srobo-legacy/boards-jointio-hw/gerbers/README.txt

Student Robotics
Contact: Rob Spanton
Email:   rspanton@studentrobotics.org
Phone:   XXXXXXXXXXXX
--------------------------------------------------------------------------------
Board Reference:  sr_jointio
Board Issue:      SR13.F
--------------------------------------------------------------------------------
Bare Board Test:      Yes
Layers:               2
Copper Weight:        1oz
Material:             1.6mm FR4
Solder Resist:        GREEN on 2 sides
Silk Screen:          WHITE on 2 sides
--------------------------------------------------------------------------------
Layer Order:
top
bottom
--------------------------------------------------------------------------------
Gerber Files:
jointio.top.gbr       - Top Copper Layer
jointio.bottom.gbr        - Bottom Copper Layer
jointio.topmask.gbr   - Solder Mask Top
jointio.bottommask.gbr    - Solder Mask Bottom
jointio.toppaste.gbr  - Solder Paste Top
jointio.bottompaste.gbr   - Solder Paste Bottom
jointio.topsilk.gbr   - Silk Screen Top
jointio.bottomsilk.gbr    - Silk Screen Bottom
jointio.outline.gbr     - Board Outline
jointio.fab.gbr         - Fabrication/Drill Drawing
jointio.plated-drill.cnc   - Plated Hole Drill Information
jointio.unplated-drill.cnc - Unplated Hole Drill Information
--------------------------------------------------------------------------------
If there are any problems please contact Student Robotics using the details at
the top of this file.
