srobo-legacy/boards-jointio-hw/(list of files, drawings)

Other design files:
jointio.pcb
