srobo-legacy/boards-jointio-hw/(commit log)

2010-09-23 Add a makefile copied from the motor-hw.git repo
2010-09-23 Add .gitignore file copied from motor-hw.git
2010-09-23 Begin schematic
    [jointio.sch]
2010-09-23 Add SRIC symbol and MSP430F22x4 along with a decoupling cap
    [jointio.sch]
2010-09-23 Add the Spy-bi-wire programming header for the MSP
    [jointio.sch]
2010-09-23 Wire up SRIC to the MSP, same pin mapping as on the motor board
    [jointio.sch]
2010-09-23 Add input LEDs
    Controlled by the MSP, it detects the logic level present on the input
    and sets the corresponding LED accordingly.
    [jointio.sch]
2010-09-23 Allocate a port on the MSP for 8 outputs
    [jointio.sch]
2010-09-23 Move HT, GT and TX_EN signals onto pins that are not ADC inputs
    Unfortunately the pins that those signals were using are needed for the
    analogue inputs.
    [jointio.sch]
2010-09-23 Add nets for ADC inputs to MSP
    [jointio.sch]
2010-09-23 Add debugging/SRIC activity LED
    [jointio.sch]
2010-09-23 Shuffle stuff around in the schematic, no electrical changes
    [jointio.sch]
2010-09-23 Add input connector and protection resistors/clamping diodes
    [jointio.sch]
2010-09-23 Add TVS diodes to the 3.3V rail
    If all 8 inputs have 12V connected then 70mA will need to be drawn from
    the 3.3V rail to stop it from rising above 3.3V. The TVS diode should clamp
    the rail to a reasonable value under these conditions.
    [jointio.sch]
2010-09-23 Add output connector and driver FETs/polyfuses
    [jointio.sch]
2010-09-23 Actually name the nets connected to the input LEDs correctly
    [jointio.sch]
2010-09-23 Add output LEDs
    [jointio.sch]
2010-09-23 Schematic shuffle, not elec changes.
    [jointio.sch]
2010-09-24 Add the SMPS. Based on the design on the power board
    [jointio.sch]
2010-09-24 Add a power LED to the 3V3 SMPS rail
    [jointio.sch]
2010-09-24 Add a FET to enable/disable the SMPS from the MSP
    The pull-up disables the SMPS by default.
    [jointio.sch]
2010-09-24 Connect the SMPS to the output FETs
    [jointio.sch]
2010-09-24 Add values to the output FETs
    [jointio.sch]
2010-09-24 Add values to the input protection diodes
    [jointio.sch]
2010-09-24 Add value to SRIC 3.3V rail TVS diode
    [jointio.sch]
2010-09-24 Add 3.3V and GND connectors, both protected by polyfuses
    The GND connections need to be protected by a fuse just as much as the
    3.3V connections. If they can connect 12V to an input or output they
    can connect 12V to the GND connections.
    [jointio.sch]
2010-09-24 Add some TVS diodes to the SMPS 3.3V rail
    Don't want things breaking when they connect 12V to the 3.3V connector.
    It shouldn't matter too much if that rail does rise as it's only used
    for the 3.3V output connector and to power the output FETs.
    [jointio.sch]
2010-09-24 Add MSP value
    [jointio.sch]
2010-09-24 Add values to the remaining un-valued SMPS components
    [jointio.sch]
2010-09-24 Add values to the output polyfuses
    [jointio.sch]
2010-09-24 Add values to the 3.3V and GND connection polyfuses
    [jointio.sch]
2010-09-24 Add values to the input/output and 3.3V/GND connectors
    [jointio.sch]
2010-09-24 Add values to the input and output LEDs
    [jointio.sch]
2010-09-24 Change the LED and input protection resistors to resistor arrays
    They reduce the overall part count and therefore ease assembly
    [jointio.sch]
2010-09-24 Number all of the components
    [jointio.sch]
2010-09-24 Add footprint attributes to all components that use existing footprints
    [jointio.sch]
2010-09-25 Add footprint attributes to the resistor arrays and output FETs
    [jointio.sch]
2010-09-25 Add footprint attribute for SMPS inductor
    [jointio.sch]
2010-09-25 Add footprint attribs to the in/out/3.3/GND connectors and a misc resistor
    [jointio.sch]
2010-09-25 Generate initial PCB file. Setup units/grid/DRC/layers
    [jointio.pcb]
2010-09-25 Insert standard SRIC layout
    [jointio.pcb]
2010-09-25 Place the connectors around the edge of the board
    [jointio.pcb]
2010-09-26 Place input LEDs
    [jointio.pcb]
2010-09-26 Place output LEDs
    [jointio.pcb]
2010-09-26 Flip the LED resistor arrays around to ease routing
    [jointio.sch]
2010-09-26 Position input/output LED resistors
    [jointio.pcb]
2010-09-26 Swap input and output connectors around, eases routing
    [jointio.pcb]
2010-09-26 Position input protection resistors and diodes
    [jointio.pcb]
2010-09-26 Place output fuses and FETs
    [jointio.pcb]
2010-09-26 Place 3.3V/GND connector fuses
    [jointio.pcb]
2010-09-26 Place 3.3V SMPS power LED
    [jointio.pcb]
2010-09-26 Flip the input LED and ADC connections around to ease routing
    [jointio.pcb, jointio.sch]
2010-09-26 Place input TVS diode
    [jointio.pcb]
2010-09-26 Place 3.3V SMPS TVS diodes
    [jointio.pcb]
2010-09-26 Route traces between input/output LEDs and resistors
    [jointio.pcb]
2010-09-26 Route input traces to protection resistors/doides
    [jointio.pcb]
2010-09-26 Route output FET and fuse traces
    [jointio.pcb]
2010-09-26 Route traces to 3.3V and GND connectors
    [jointio.pcb]
2010-09-26 Route output lines towards MSP
    [jointio.pcb]
2010-09-26 Change input protection resistors back to indivudal ones
    Turns out the array was a bit of a pain for routing.
    [jointio.pcb, jointio.sch]
2010-09-26 Route Vcc and GND to input clamping diodes
    [jointio.pcb]
2010-09-26 Route input LED traces to a bunch of vias ready to go to the MSP
    [jointio.pcb]
2010-09-27 Route traces for input LEDs from MSP
    [jointio.pcb]
2010-09-27 Route output control lines to MSP
    [jointio.pcb]
2010-09-27 Route GND to the output FETs
    [jointio.pcb]
2010-09-27 Route inputs to MSP
    [jointio.pcb]
2010-09-27 Place and route input TVS diode
    [jointio.pcb]
2010-09-27 Route SRIC signals to MSP
    [jointio.pcb]
2010-09-27 Place and route SRIC activity LED
    [jointio.pcb]
2010-09-27 Place and route MSP programming header
    [jointio.pcb]
2010-09-27 Place SMPS components
    [jointio.pcb]
2010-09-27 Route majority of SMPS
    [jointio.pcb]
2010-09-27 Route last few rats. All routing complete
    [jointio.pcb]
2010-09-27 Reduce pcb layout canvas size to the size of the board
    [jointio.pcb]
2010-09-27 Move a trace in from the edge of the board
    [jointio.pcb]
2010-09-27 Add silk text labels next to the 3V3/GND/IN/OUT connectors
    [jointio.pcb]
2010-09-27 Nudge the connectors up to the edge of the board fully
    [jointio.pcb]
2010-09-28 Position all refdeses on layout
    [jointio.pcb]
2010-10-02 Neaten up lots of traces
    [jointio.pcb]
2010-10-02 Add ground plane logical layers
    [jointio.pcb]
2010-10-02 Add ground plane to top side
    [jointio.pcb]
2010-10-02 Add ground plane to the reverse side
    [jointio.pcb]
2010-10-02 Add lots of vias linking the ground planes on the two sides
    [jointio.pcb]
2010-10-02 Move refdeses around so that they're not overlapping vias
    [jointio.pcb]
2010-10-02 Add identifying text to copper
    [jointio.pcb]
2010-10-06 Add SR logo to the top copper layer
    [jointio.pcb]
2010-10-06 Increase clearance around some vias to remove slivers of ground plane
    [jointio.pcb]
2010-10-07 Add gerbers used for manufacture of the prototype
    [jointio.back.gbr, jointio.fab.gbr, jointio.front.gbr]
2010-12-05 Remove polyfuse from the GND output and increase value of the 3.3V polyfuse
    The polyfuse on the GND header interferes with things too much. The added
    voltage drop affects measured analogue values and also limits the maximum
    current available to source from all of the outputs as the current has to
    sink into the GND connector.
    The 3.3V polyfuse was too small and like the GND one would have limited
    the maximum current which could be sinked into the outputs. I've increased
    it massively and will let the SMPS current limit take care of any shorts.
    The polyfuse is now there to protect against 12V being input into the 3.3V
    header.
    The GND header doesn't have any protection against having 12V injec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
    [jointio.pcb, jointio.sch]
2010-12-05 Joint a GND trace onto the ground plane
    Must have got missed when I joined them all on before.
    [jointio.pcb]
2010-12-05 Move some of the ID text to the top layer and use the canonical domain name
    Move the board name and the board year/revision ID to the top of the board
    and expand 'srobo.org' to 'studentrobotics.org'.
    [jointio.pcb]
2010-12-29 Start case design. Layout panels ready for tabs/cut-outs
    [case.dxf]
2010-12-29 Add the cut-outs to the side panels of the case for the connectors
    [case.dxf]
2010-12-29 Add T-slot fixings between the side panels and the top face of the case
    [case.dxf]
2010-12-29 Add T-slot fixings between the side panels and bottom face of the case
    [case.dxf]
2010-12-29 Add mounting slots to the base of the case
    [case.dxf]
2010-12-29 Add finger cut-outs to base of case to get at the RJ45 tabs
    [case.dxf]
2010-12-29 Add interlocking corner tabs between the side panels of the case
    [case.dxf]
2010-12-29 Add lines to split case side panels into two halves
    [case.dxf]
2010-12-29 Add some interlocking wiggles between the halves of the side panels
    There was very little stopping the two halves of the case from sliding around
    other than a small bit of overlap with the tops of connectors.
    [case.dxf]
2010-12-29 Add cable-tie tabs to the side panels of the case
    Added the tabs to all four corners and I can see it being a bit flimsy with
    just two of them. We don't have to put four cable ties on if it's fine with
    just two or three.
    [case.dxf]
2010-12-29 Add another tab to the top panel of the case to hold a side panel on better
    [case.dxf]
2011-02-14 Update the board ID to indicate it's the final design
    [jointio.pcb]
2011-02-16 Add gerbers used for final manufacture
    [jointio.back.gbr, jointio.backmask.gbr, jointio.backpaste.gbr, jointio.backsilk.gbr, jointio.fab.gbr, jointio.front.gbr, jointio.frontmask.gbr, jointio.frontpaste.gbr]
2011-02-16 Add README in gerbers dir for PCB fab
2011-03-09 Add the stepped up gerbers
2011-03-10 Add gerbers used for solder paste stencil
2011-03-14 Increase width of the case slots by 0.1mm
    When assembling the motor board cases we found that the tolerance of the
    acrylic thickness meant that some side panels would not fix into the top/
    bottom panels. They only required a tiny amount of material removing to
    then fit correctly.
    [case.dxf]
2012-06-28 Convert layout to the latest PCB format
    PCB now stores all sizes with units, hence the massive diff. The design itself
    has not changed at all in this commit.
    [jointio.pcb]
2012-06-28 Increase the visibility of the labels
    Where there's space I've duplicated labels in copper as well as in silk. This
    doesn't change the board electrically.
    [jointio.pcb]
2012-06-28 Add a box in silk for the board asset code
    [jointio.pcb]
2012-08-21 Update board label to 'SR13.F'
    This board is being manufactured in SR2013, so we bump the revision
    number.
    [jointio.pcb]
2012-08-21 Delete stepped gerbers
    Now obsolete.
2012-08-21 Generate SR13.F gerber files
    Ready for manufacture.
    [jointio.back.gbr, jointio.backpaste.gbr, jointio.backsilk.gbr, jointio.bottom.gbr, jointio.bottommask.gbr, jointio.bottompaste.gbr, jointio.bottomsilk.gbr, jointio.fab.gbr]
2012-08-21 Update README associated with gerbers
2012-12-23 Add a makefile target to generate pdf of schematic
