srobo-legacy/boards-jointio-hw/case.dxf

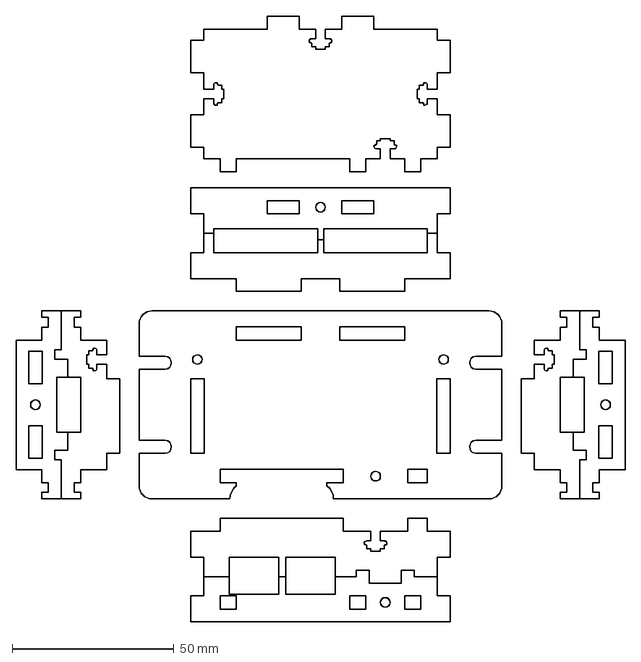
[picture p1: CAD file, 2011-03-14]
case.dxf
188.0 x 187.0 mm
